AlieksieievYurii/vacuum-cleaner/docs/accumulator.md

# Accumulator

This section describes the process of creating the accumulator for the project

Overview:</br>
Cells: **4S**</br>
Charging Voltage: **16.8V**</br>
Capacity: **+- 5 Ah**

[18650 Battery](https://allegro.pl/oferta/akumulator-18650-samsung-3500mah-35e-nowe-11328113273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)

[BMS](https://www.aliexpress.com/item/1005002369756124.html?spm=a2g0o.order_detail.0.0.6509f19c1LpNGw)

Circuit:



Outputs (v-Bx-Bx) are supposed to be connected to the microcontroller so that the microcontroller reads the cell voltages.

Calculating voltages of the cells:</br>
`actual v-B1-B5 = v-B1-B5 - 0`</br>
`actual v-B2-B6 = v-B2-B6 - v-B1-B5`</br>
`actual v-B3-B7 = v-B3-B7 - v-B2-B6`</br>
`actual v-B4-B8 = v-B4-B8 - v-B3-B7`</br>

Images:
