AlieksieievYurii/vacuum-cleaner/docs/prices.xlsx

Item | Amount | Price(PLN) | Delivery(PLN) | Sum | Description
Xiaomi Wheel module | 2 | 80 | 9 | 169 | Wheel modul from Xiaomi Robot containing motor and two hall sensors to measure RPM and direction
TA6586 | 5 | 7.5 | 0 | 37.5 | Motor Driver for DC motor. V-range: 3.0-14V, 10A
Xiaomi Details Kit | 1 | 40 | 8.8 | 48.8 | Xiaomi Details Pack: 2x Size Brushes, Main Brush, 2x Filters
DC Motor 12V 10000 RPM | 1 | 39 | 0 | 39 | DC Motor 12V 10000 RPM
Basic Kit Raspbery PI Zero W | 1 | 110 | 0 | 110 | The packet contains: RP, Power Supply, Cover
2x RP Zero radiator | 1 | 6 | 0 | 6
SN-01BM Crimping pliers tool | 1 | 90.22 | 0 | 90.22 | SN-01BM Crimping pliers tool set-1550pcs 2.54mm Dupont connectors and crimp pins，460pcs 2.54 mm JST-XH JST connector kit
IR Infrared Obstacle Avoidance Sensor Module | 6 | 1.73 | 3 | 13.38 | Smart Electronics New for Arduino Diy Smart Car Robot Reflective Photoelectric 3pin IR Infrared Obstacle Avoidance Sensor Module
JGA25-370 Geared motor DC | 2 | 15.76 | 15 | 46.52 | 1x - DC6V150RPM, 1x - DC12V200RPM
10 Pairs Battery Contact Springs | 2 | 11.74 | 0 | 23.48 | 10Pairs 18650 Battery Contact Spring Contact Band Plate 18.5*16MM 16.5*16mm Connector Positive Electrode Negative Box/Power Bank
ABS 18650 Power Bank Cases 2X | 4 | 4.51 | 0 | 18.04 | ABS 18650 Power Bank Cases 1X 2X 3X 4X 18650 Battery Holder Storage Box Case 1 2 3 4 Slot Batteries Container With Hard Pin
BMS 18650 4S | 3 | 6.66 | 0 | 19.98 | BMS 1S 2S 10A 3S 4S 5S 25A Bms 18650 Li-ion Lipo Lithium Battery Protection Circuit Board Module Pcb Pcm 18650 Lipo Bms Charger
10x 5V Regulator | 1 | 5 | 0 | 5 | 10pcs L7805CV L7805 7805 Voltage Regulator 5V 1.5A TO-220
Small 360 Wheel | 1 | 10 | 0 | 10
Tought Switch | 2 | 13 | 0 | 26
Switch Button | 1 | 15 | 0 | 15 | Switch Button with Led
Input Holes 5m | 1 | 7 | 0 | 7
Hexagonal copper Shaft 3.17m | 2 | 2.23 | 3.85 | 8.31 | Hexagonal copper Shaft Coupling 3.17mm Coupler Motor Transmission Connector model car Tire connector with M4 Screw
M3 Brass Hot Melt Inset Nuts Kit Thread | 1 | 64.15 | 0 | 64.15 | Brass Hot Melt Inset Nuts Assortment Kit Thread Copper Knurled Threaded Insert Embedment Nuts Set
Screws M3L10 | 1 | 7 | 0 | 7
Screws M3L25 | 2 | 7 | 0 | 14
Bearing 22M7.8M | 1 | 5 | 0 | 5
Bearing 16M7.8M | 1 | 5 | 0 | 5
Arduino Mega | 1 | 70 | 0 | 70 | MEGA 2560 R3
Screws M3x6mm 10X | 2 | 14
Screws M3x40mm 10X | 1 | 14
Step-Down XL4015 DC-DC converter | 1 | 12
HC-SR04 | 3 | 5
RTC DS3231 | 1 | 15
PAM8302 2.5W | 1 | 28
Speaker YD50-P 0,5W 8Ohm - 50x17mm | 1 | 3
 |  |  |  |  |  | Summa
 |  |  |  |  |  | 858.38
