AlieksieievYurii/vacuum-cleaner/(threads)

Thread 15 (2022-07-20):

Power controller PCB v2

AlieksieievYurii, 2022-07-20:
Create new PCB for power controller counting previous mistakes: the relay must control negative voltage instead of positive

AlieksieievYurii, 2022-08-02:
The PCB has been projected....awaiting for it from JLCPCB

AlieksieievYurii, 2022-08-23:
Done and tested!

Closed 2022-08-23.

Thread 21 (2022-08-24):

Battery is not stable.

AlieksieievYurii, 2022-08-24:
Check why the battery is charging fast and due to that the capacity is not big.

AlieksieievYurii, 2022-09-25:
FIXED!

Closed 2022-09-25.

Thread 22 (2022-08-24):

Battery Capacity

AlieksieievYurii, 2022-08-24:
Refactor the code in A1 and Core to get how charged is battery. Also display it in Android App

AlieksieievYurii, 2022-09-25:
FIXED!

Closed 2022-09-25.

Thread 37 (2023-06-05):

recreate this robot

NinjaAtWork, 2023-06-05:
Hi Sir
this is really a promising robot among many DIY that i searched for. thanks for sharing .
i have a wasp 3d printer and if you mind i am going to make this robot for home.
may i ask for cad/stl for printing? or link if you uploaded them somewhere.
i am using Inventor and will be glad if you can share the cad since the stock and inventory available here needed to be adjusted in overall design.
thanks again.
my mail is : saeedhzm@gmail.com

AlieksieievYurii, 2025-05-03:
They are available in the release: https://github.com/AlieksieievYurii/vacuum-cleaner/releases/tag/release

Closed 2025-05-03.

Thread 38 (2024-09-28):

STL files?

Kreijstal, 2024-09-28:
How are we supposed to print this?

AlieksieievYurii, 2025-05-03:
They are available in the release: https://github.com/AlieksieievYurii/vacuum-cleaner/releases/tag/release

Closed 2025-05-03.

Thread 39 (2025-03-04):

CAD/STL files

orange00, 2025-03-04:
Hi,

thanks for the awesome project.

Is there a way you could send me the CAD project and STL files?

I can send you my email if you want to do it privately.

Thx in advance :)

AlieksieievYurii, 2025-05-03:
https://github.com/AlieksieievYurii/vacuum-cleaner/releases/tag/release

Closed 2025-05-03.
