AlieksieievYurii/vacuum-cleaner/android-app/app/src/main/java/com/yurii/vaccumcleaner/robot/Robot.kt

package com.yurii.vaccumcleaner.robot

interface Robot {
    suspend fun walkForward(speedCmPerMinute: Int)
    suspend fun walkBackward(speedCmPerMinute: Int)
    suspend fun rotateLeft(speedCmPerMinute: Int)
    suspend fun rotateRight(speedCmPerMinute: Int)
    suspend fun stopMovement(withBreak: Boolean)
    suspend fun setVacuumMotor(value: Int)
    suspend fun setMainBrushMotor(value: Int)
    suspend fun setLeftBrushMotor(value: Int)
    suspend fun setRightBrushMotor(value: Int)
    suspend fun getRobotInputData(): RobotInputData
    suspend fun getCurrentPidSettings(): PidSettings
    suspend fun setPidSettings(pidSettings: PidSettings)
    suspend fun getAlgorithms(): AlgorithmList
    suspend fun setAlgorithm(algorithm: Algorithm)
    suspend fun startCleaning()
    suspend fun pauseCleaning()
    suspend fun resumeCleaning()
    suspend fun stopCleaning()
    suspend fun getCleaningStatus(): CleaningStatus
    suspend fun shutDown()
    suspend fun reboot()
    suspend fun getCurrentWpaConfig(): WpaConfig
    suspend fun setWifiSettings(wifiSettings: WifiSettingsRequestModel): NetworkInfo
    suspend fun getNetworkScan(): NetworkScan
}
