AlieksieievYurii/vacuum-cleaner/motherboard/a1/src/wheels.h

#ifndef __wheels_h__
#define __wheels_h__

#include <Arduino.h>
#include "instruction-handler.h"

// How many pulses in one 360 rotation, must be measured manually!!!!
#define ENC_COUNT_REV 235

// Distance made by a full rotation. Diameter of the wheel: 67.5 mm -> Pi * 67.5 => 212 mm
#define FULL_ROTATION_DISTANCE 212

#define CALL_INTERVAL 50
#define CALL_INTERVAL_IN_SECONDS 0.05

#define WHEELS_BASE_LINE_DIAMETER_MM 290

enum WheelState : byte {
  IDLE, MOVING, ENDLESS_WALKING, STOPPED
};

enum SideDirection : byte {
  LEFT, RIGHT
};

class Wheel {
  public:
    Wheel(uint8_t forward_pin, uint8_t backward_pin, uint8_t speed_sensor, uint8_t direction_sensor, void (*pulse_interupt)());
    WheelState wheel_state = IDLE;
    volatile uint16_t speed = 0.0; // sm per minute
    void set_PID(float kp, float ki, float kd);
    void tick(); // Must be called every CALL_INTERVAL milliseconds
    void move(uint32_t distanse_sm, uint32_t speed, bool with_break, bool forward);
    void walk(uint32_t speed_sm_per_minute, bool forward);
    void pulse();


  private:
    uint8_t _forward_pin, _backward_pin, _speed_sensor, _direction_sensor;
    volatile float _kp, _ki, _kd;
    volatile float _integral = 0, _prev_err = 0;
    volatile uint32_t _wheel_pulses_for_speed = 0;
    volatile uint64_t _wheel_pulses_count = 0;
    volatile bool _direction_is_forward;
    volatile uint64_t _pulses_to_move = 0;
    volatile float _speed_setpoint = 0; // sm per minute
    bool _with_break = false;
    bool _forward_direction_to_move = false;
    void _measure_speed();
    void _measure_pid_and_set_speed();
};

class Wheels {
  public:
    Wheels(InstructionHandler &instruction_handler, Wheel &left_wheel, Wheel &right_wheel);
    void tick(); //Must be called from the main loop
    void move(uint16_t request_id, uint32_t distance_sm, uint32_t speed_sm_per_minute, bool forward, bool with_break);
    void walk(uint16_t request_id, uint32_t speed_sm_per_minute, bool forward);
    void turn(uint16_t request_id, SideDirection side_direction, uint16_t degree, uint32_t speed_sm_per_minute, bool with_break);
    void rotate(uint16_t request_id, SideDirection side_direction, uint32_t speed_sm_per_minute);

  private:
    InstructionHandler* _instruction_handler;
    Wheel* _left_wheel;
    Wheel* _right_wheel;
    bool _is_moving = false;
    uint16_t _request_id;

};

#endif
