AlieksieievYurii/vacuum-cleaner/(commit log)

2021-09-19 Create Bluetooth Device Fragment
2021-09-19 Create list of bluetooth devices(UI only)
2021-09-22 Add a few extensions: flowLifecycler observer, update list for StateFlow
2021-09-25 Make BL device public
2021-09-25 Add sonarlint to gitignore
2021-09-25 Move the package Devices to a package
2021-09-25 Add logic to navigate beetwen fragments and pass the BL device
2021-09-26 Create service to work with communication between raspberry pi and Android App via bluetooth
2021-09-26 Fix the bl communicator
    [models.py]
2021-10-13 Fix the client send
    [models.py]
2021-10-17 Add BL powering off option
2022-06-04 Add scematic and pcb of Power Controller
2022-06-04 Create folder containing cirtuitand pcb for motherboard
2022-06-28 Add class which handles Led states
2022-06-29 Implement instuction for buzzer
    [config.h, implementation.h, src.ino]
2022-06-30 Pass instruction handler inside Buzzer class so that it sends callback state
    [buzzer.cpp, buzzer.h, implementation.h]
2022-07-02 Add the fun to enable Hardware Timer 5
2022-07-03 Create class for controlling wheel
2022-07-04 Implement Wheels class
2022-07-04 Wrap reading sensor steps into macro condition
2022-07-04 Change the way of calculating angle distance and fix the bugs
    [implementation.h, wheels.cpp, wheels.h]
2022-07-06 Create a script for configuring PID
2022-07-06 Somehow implemented wheel class
2022-07-06 Define Vacuum motor
2022-07-06 Create class for smoth motor controlling
2022-07-06 Register and implement the instruction for vacuum motor
2022-07-06 Define Left Brush motor
2022-07-06 Implement instruction for Left Brush motor
2022-07-06 Define Right Brush Motor
2022-07-06 Add implementation for right brush motor
2022-07-12 Create simple class for measurement cells voltage
2022-07-12 Create an instruction with response: return current battery status
2022-07-13 Add an instuction to get current time from A1
2022-07-13 Replace just number with define
    [implementation.h]
2022-07-16 Create class to hanle DHT11 sensor
2022-07-16 Init pin for temp sensor
2022-07-16 Add instuction to get temp and humidity including heat index
2022-07-19 Create skatch for Power Controller
2022-07-19 Create interface in A1 for communication with Power Controller
2022-07-19 Register 3 function for setting state into Power Controller
2022-07-19 Remake the power controller class a little and add error state
    [power-controller.cpp, power-controller.h]
2022-07-19 Add instruction to set power controller states
2022-07-19 Add reading power controller states
2022-07-20 Move doc about A1 uart communication from docs to motherboard/a1
2022-07-20 Add excel file with the stuff used in the robot and their prices
    [prices.xlsx]
2022-07-28 Init port of main brush motor
2022-07-28 Register and implement instruction for main brush motor
2022-07-31 Fix bug: response contains ID without fixed number of characters
    [instruction-handler.cpp]
2022-07-31 Create fun millis
2022-08-01 Add a possiblity(fun) to move endless for wheels
2022-08-01 Swap parameters for move endless instruction
    [implementation.h]
2022-08-01 Create Robot class which is an abstract level on UART protocol
2022-08-13 Assigned names to the threads
2022-08-13 Close the socket connection when found it
2022-08-13 Create thread that keeps occured exception
2022-08-15 Insert WifiCommunicator to Application
2022-08-15 Handle the case when RequestHandler endpoint does not require parameters
2022-08-15 Implement listeners for buttons of robot movements
2022-08-15 Implement empty fun for setting wheel speed
2022-08-20 Rename communicator class communicator <-> socket
2022-08-20 Create Wifi endpoint for managing motor states
2022-08-20 Register motor wifi endpoint
2022-08-20 AndroidApp: add funs to set motors
2022-08-20 AndroidApp: Implement setting motor for main brush
2022-08-20 Core: Add endpoint for controlling motors
2022-08-20 A1: Increase motor dispersal
2022-08-20 AndroidApp: Add remaning motor setters
2022-08-20 AndroidApp: Make usage of WheelSpeed
2022-08-21 AndroidApp: Replace algo that calculates number of hosts, with simple switch case
2022-08-22 PowerController: refactor the code
2022-08-22 PowerController: Init battery cells
2022-08-23 PowerController: remake communication with A1
2022-08-23 A1: Remake i2c comm with the Power Controller
2022-08-23 Change id of commands for Power Controller
2022-08-23 Core: Add parsing cliffs and battery cells
2022-08-24 Set wheel speed limit
2022-08-24 Change the UART port
2022-09-02 Core: add function to print error in display
    [display.cpp, display.h]
2022-09-02 Core: add displaying battery state
2022-09-03 Core: put work with diplay on hold due to memory issue
    [display.cpp, display.h]
2022-09-03 Core: add reading bluetooth button
2022-09-03 A1: Fix wrong bit for bluetooth button state
    [implementation.h]
2022-09-03 Core: Add reading button states
2022-09-04 PowerController: Make reading the whole battery voltage
2022-09-06 PC: remove checing if there is constant current
2022-09-06 Core: Add validation if socket is created
2022-09-06 Core: implement parsing battery capacity and voltage
2022-09-07 Core: make UART service as deamon
2022-09-07 A1: Add instruction to set timer of cutting off the power
2022-09-07 PC: Add option if long press button -> turn off forcefully
2022-09-07 Core: add checking if charging
2022-09-11 Core: fix the issue with timeout
    [models.py, socket.py]
2022-09-11 Core: Change logger format -> add printing module name
2022-09-11 Core: replace print with logger
2022-09-25 AndroidApp: Group manual control button into FragmentLayout
2022-09-25 AndroidApp: Group history button into widget(FrameLayout)
2022-09-25 AndroidApp: Create widget button for setting PID
2022-09-25 AndroidApp: create button for algo settings
2022-09-25 AndroidApp: Create start button
2022-09-26 AndroidApp: Create BatteryView
2022-09-27 AndroidApp & Core: Implement reading battery state
2022-09-28 AndroidApp: Create style for Button
2022-09-28 AndroidApp: Create fragment for PID settings
2022-09-28 AndroidApp: implement navigation to PID settings
2022-09-28 AndroidApp: Create calling endpoint to get and set pid settings
2022-09-28 AndroidApp: Implement UI PID setting
2022-09-28 AndroidApp: add displaying errors in pid settings
2022-10-03 Core: add fun to get current algo script name
2022-10-03 AndroidApp: bind parameter to arg of current script
2022-10-03 Core: add current script into the response
2022-10-04 Core: 1. Fix the wrong validation of fields. 2. Add recursive parsing of fields
    [models.py]
2022-10-05 AndroidApp: Simplify adding switch&seek views
2022-10-05 AndroidApp: move battery state to the view directly
2022-10-05 AndroidApp: Implement listening for battery change in ManualControl
2022-10-05 AndroidApp: implement error handling in ManualControl
    [ManualControlFragment.kt, ManualControlViewModel.kt]
2022-10-05 AndroidApp: set default value for wheel speed
2022-10-05 A1: Add reading wheel speed
2022-10-05 Core&AndroidApp: implement reading wheel speed
2022-10-05 A1: Add an instruction to set PID
2022-10-05 Core: Implement the instruction to set PID
2022-10-05 Core: Add function to fetch current PID settings
2022-10-05 Core: Create endpoint to get current pid settings
2022-10-05 AndroidApp: Implement endpoint to get pid settings
2022-10-05 Core: create endpoint to set pid settings
2022-10-05 AndroidApp: Handle endpoint to set pid
2022-10-05 AndroidApp: Close Pid settings fragment once it is applied
2022-10-06 Core: set PID
2022-10-07 Core: Fix wrong thread definition. Also add mock function is_paused
2022-10-07 Core: Add endpoint to start cleaning and get current status
2022-10-08 AndroidApp: Fix the wrong endpoint
    [RobotWifiImpl.kt]
2022-10-08 AndroidApp: Create shutdown button
2022-10-08 AndroidApp: Integrate shutdown button into panel
2022-10-08 AndroidApp: Add endpoint to request to shutdown and reboot
    [Robot.kt, RobotMockUpImpl.kt, RobotWifiImpl.kt]
2022-10-08 AndroidApp: Create menu options for power
2022-10-08 AndroidApp: Implement button for shuting down the robot
2022-10-16 Core: Fix the problem with fetching current PID settings
2022-10-16 PowerController: Add command to set booting up led
2022-10-16 AndroidApp: Add API's models to ask to shutdown and reboot
    [RobotWifiImpl.kt]
2022-10-22 Core: Add configurable UART speed
2022-10-29 AndroidApp: Register buttons callbacks
2022-10-29 Core: Add endpoint to get current WPA
2022-10-29 Core: Implement function to get current WPA config in OS class
2022-10-29 AndroidApp: Implement fetching the current WAP settings with the new API
2022-10-29 AndroidApp: Add new fun to the API: Get current WPA settings
2022-10-30 AndroidApp: Implement closing the socket
2022-10-30 AndroidApp: Print mask if error
2022-11-01 A1: Add instruction to handle BL leds
2022-11-01 Core: Hanlde BL button
2022-11-01 Core: Add fun to enable A1 BL leds
2022-11-01 Core: Add fun to enable A1 Wifi & Error leds
    [robot.py]
2022-11-01 Core: Add setting Error state if error occured in the loop
    [robot.py]
2022-11-01 A1: Reset error state
    [src.ino]
2022-11-01 AndroidApp: Proper close the sockets
2022-11-01 Core: Fix the re to fetch current WPA
2022-11-08 Core: Fix the warnings from sonarlint
    [models.py]
2022-11-08 Core: Fix sonarline issues in algo manager
2022-11-08 Core: Fix other sonarlint warnings
    [models.py]
2022-11-09 Core: Add turning on Vacuum motor
2022-11-09 Core: disable all motors when shut down
2022-11-11 Await unit setting motors are set
